Wazneh/rfcx-guardian-pcb/README.md

# rfcx-guardian-pcb
Hardware PCB designs for RFCx Guardians
