Wazneh/rfcx-guardian-pcb/BOM/BOM_RFCX_POWER_BOARD_R1.xlsx

Description | Device | Package | Value | Qty | Price | Ex. Price | Parts | MFG PN | Manufacturer | Digikey PN | Digi cart
3.5mm Terminal block | TERMBLOCK_1X2 | TERMBLOCK_1X2-3.5MM | 2POS HORIZ 3.5MM T/H | 1 | $0.57 | $0.57 | X1 | 691103110002 | Wurth Electronics Inc. | 732-2745-ND (https://www.digikey.com/product-detail/en/wurth-electronics-inc/691103110002/732-2745-ND/2508514)
CAPACITOR, American symbol | C-USC1210 | C1210 | 100uF | 1 | $0.58 | $0.58 | C18 | GRM32ER61A107ME20L | Murata | 490-9969-1-ND (https://www.digikey.com/product-detail/en/murata-electronics-north-america/GRM32ER61A107ME20L/490-9969-1-ND/5026474) | CAP CER 100UF 10V X5R 1210
CAPACITOR, American symbol | C-USC0805K | C0805K | 10uF | 7 | $0.08 | $0.56 | C1, C2, C3, C5, C6, C7, C15 | CC0805KKX5R7BB106 | Yageo | 311-1865-1-ND (https://www.digikey.com/products/en?keywords=311-1865-1-ND) | CAP CER 10UF 16V X5R 0805
Ceramic Capacitors | CAP_CERAMIC0805_10MGAP | 0805_10MGAP | 0.1uF | 1 | $0.02 | $0.02 | C17 | CC0805ZRY5V9BB104 | Yageo | 311-1361-1-ND (https://www.digikey.com/product-detail/en/yageo/CC0805ZRY5V9BB104/311-1361-1-ND/2103145) | CAP CER 0.1UF 50V Y5V 0805
Ceramic Capacitors | CAP_CERAMIC0805-NOOUTLINE | 0805-NO | 2.2uF | 1 | $0.04 | $0.04 | C16 | CL21A225KAFNNNG | Samsung | 1276-6458-1-ND (https://www.digikey.com/product-detail/en/samsung-electro-mechanics-america-inc/CL21A225KAFNNNG/1276-6458-1-ND/5958086) | CAP CER 2.2UF 25V X5R 0805
Diode | DIODESOD-123 | SOD-123 | MBR120VLSFT1G | 3 | $0.24 | $0.73 | D1, D2, D3 | MBR120VLSFT1G | ON Semi | MBR120VLSFT1GOSCT-ND (https://www.digikey.com/product-detail/en/on-semiconductor/MBR120VLSFT1G/MBR120VLSFT1GOSCT-ND/893874) | DIODE SCHOTTKY 20V 1A SOD123FL
Inductors | INDUCTORTDK_VLC5045 | INDUCTOR_5X5MM_TDK_VLC5045 | 6.8uH | 1 | $0.30 | $0.30 | L2 | VLS5045EX-6R8M | TDK Corp. | 445-174855-1-ND (https://www.digikey.com/product-detail/en/tdk-corporation/VLS5045EX-6R8M/445-174855-1-ND/6560412) | FIXED IND 6.8UH 2.9A 59.8 MOHM
JST 2-Pin Connectors of various flavors | JST_2PIN-SMT-RA | JST-PH-2-SMT-RA | 3.7 - 4.2 V | 2 | $0.10 | $0.20 | BATT, BATT1 | S2B-PH-SM4-TB(LF)(SN) | JST Sales America Inc. | 455-1749-1-ND (https://www.digikey.com/product-detail/en/jst-sales-america-inc/S2B-PH-SM4-TB(LF)(SN)/455-1749-1-ND/926846) | CONN HEADER PH SIDE 2POS 2MM SMD
LED | LED0805_NOOUTLINE | CHIPLED_0805_NOOUTLINE | BLUE | 1 | $0.14 | $0.14 | LED4 | 150080BS75000 | Wurth | 732-4982-1-ND (https://www.digikey.com/product-detail/en/wurth-electronics-inc/150080BS75000/732-4982-1-ND/4489910) | LED BLUE CLEAR 0805 SMD
LED | LED0805_NOOUTLINE | CHIPLED_0805_NOOUTLINE | GREEN | 2 | $0.09 | $0.19 | DONE, DONE1 | LG R971-KN-1 | OSRAM | 475-1410-1-ND (https://www.digikey.com/product-detail/en/osram-opto-semiconductors-inc/LG-R971-KN-1/475-1410-1-ND/1802598) | LED GREEN DIFFUSED 0805 SMD
LED | LED0805_NOOUTLINE | CHIPLED_0805_NOOUTLINE | RED | 2 | $0.10 | $0.20 | PWR, PWR1 | LS R976-NR-1 | OSRAM | 475-1278-1-ND (https://www.digikey.com/product-detail/en/osram-opto-semiconductors-inc/LS-R976-NR-1/475-1278-1-ND/1642798) | LED RED DIFFUSED 0805 SMD
LED | LED0805_NOOUTLINE | CHIPLED_0805_NOOUTLINE | YELLOW (edit) | 2 | $0.13 | $0.27 | CHRG/LBO, CHRG/LBO1 | LY R976-PS-36 | OSRAM | 475-2560-1-ND (https://www.digikey.com/product-detail/en/osram-opto-semiconductors-inc/LY-R976-PS-36/475-2560-1-ND/1802687) | LED YELLOW DIFFUSED 0805 SMD
MCP QFN | MCP73871 | QFN20_4MM | MCP73871 | 2 | $1.53 | $3.07 | IC1, IC2 | MCP73871-2CCI/ML | Microchip | MCP73871-2CCI/ML-ND (https://www.digikey.com/product-detail/en/microchip-technology/MCP73871-2CCI-ML/MCP73871-2CCI-ML-ND/1680971) | IC USB/AC BATT CHRGR W/PPM 20QFN
PNP Bias Resistor Transistor | MUN2114T1-PNP_DRIVER-SC59-BEC | SC59-BEC | MMUN2133LT1G | 1 | $0.07 | $0.07 | T2 | MMUN2133LT1G | ON Semi | MMUN2133LT1GOSCT-ND (https://www.digikey.com/product-detail/en/on-semiconductor/MMUN2133LT1G/MMUN2133LT1GOSCT-ND/2705149) | TRANS PREBIAS PNP 246MW SOT23-3
POLARIZED CAPACITOR, American symbol | CPOL-USE5-13 | E5-13 | 4700uF/10V | 2 | $0.62 | $1.24 | C4, C8 | UVR1A472MHD1TO | Nichicon | 493-12761-1-ND (https://www.digikey.com/product-detail/en/nichicon/UVR1A472MHD1TO/493-12761-1-ND/4328397) | CAP ALUM 4700UF 20% 10V RADIAL
RESISTOR, American symbol | R-US_R0805 | R0805 | 100K | 4 | $0.01 | $0.05 | R3, R6, R12, R16 | CR0805-FX-1003ELF | Bourns Inc. | CR0805-FX-1003ELFCT-ND (https://www.digikey.com/product-detail/en/bourns-inc/CR0805-FX-1003ELF/CR0805-FX-1003ELFCT-ND/3740923) | RES SMD 100K OHM 1% 1/8W 0805
RESISTOR, American symbol | R-US_FLIPFLOP | 0805-THM | 10K | 2 | $0.01 | $0.02 | THERM, THERM1 | RC0805FR-0710KL | Yageo | 311-10.0KCRCT-ND (https://www.digikey.com/product-detail/en/yageo/RC0805FR-0710KL/311-10.0KCRCT-ND/730482) | RES SMD 10K OHM 1% 1/8W 0805
RESISTOR, American symbol | R-US_M0805 | M0805 | 150K | 2 | $0.60 | $1.20 | RT1, RT2 | RG2012N-154-W-T1 | Susumu | RG20N150KWCT-ND (https://www.digikey.com/product-detail/en/susumu/RG2012N-154-W-T1/RG20N150KWCT-ND/600928) | RES SMD 150K OHM 0.05% 1/8W 0805
RESISTOR, American symbol | R-US_M0805 | M0805 | 1K | 2 | $0.43 | $0.86 | R5, R17 | RT0805BRB071KL | Yageo | YAG4811CT-ND (https://www.digikey.com/product-detail/en/yageo/RT0805BRB071KL/YAG4811CT-ND/6616967) | RES SMD 1K OHM 0.1% 1/8W 0805
RESISTOR, American symbol | R-US_R0805 | R0805 | 1K | 10 | $0.01 | $0.09 | R7, R8, R9, R10, R13, R14, R11, R15, R39, R40 | CR0805-JW-102ELF | Bourns Inc. | CR0805-JW-102ELFCT-ND (https://www.digikey.com/product-detail/en/bourns-inc/CR0805-JW-102ELF/CR0805-JW-102ELFCT-ND/3592930) | RES SMD 1K OHM 5% 1/8W 0805
RESISTOR, American symbol | R-US_R0805 | R0805 | 270K | 2 | $0.08 | $0.16 | R2, R4 | ERJ-PB6D2703V | Panasonic | P21294CT-ND (https://www.digikey.com/product-detail/en/panasonic-electronic-components/ERJ-PB6D2703V/P21294CT-ND/6215549) | RES SMD 270K OHM 0.5% 1/4W 0805
Resistors | RESISTOR0805_NOOUTLINE | 0805-NO | 1.87M | 1 | $0.02 | $0.02 | R42 | ERJ-6ENF1874V | Panasonic | P1.87BTCT-ND (https://www.digikey.com/product-detail/en/panasonic-electronic-components/ERJ-6ENF1874V/P1.87BTCT-ND/4429149) | RES SMD 1.87M OHM 1% 1/8W 0805
Resistors | RESISTOR_0805MP | _0805MP | 1.87M | 1 | $0.02 | $0.02 | R45 | ERJ-6ENF1874V | Panasonic | P1.87BTCT-ND (https://www.digikey.com/product-detail/en/panasonic-electronic-components/ERJ-6ENF1874V/P1.87BTCT-ND/4429149) | RES SMD 1.87M OHM 1% 1/8W 0805
Resistors | RESISTOR0805_NOOUTLINE | 0805-NO | 200K | 2 | $0.01 | $0.03 | R41, R43 | CR0805-FX-2003ELF | Bourns Inc. | CR0805-FX-2003ELFCT-ND (https://www.digikey.com/product-detail/en/bourns-inc/CR0805-FX-2003ELF/CR0805-FX-2003ELFCT-ND/3925389) | RES SMD 200K OHM 1% 1/8W 0805
Resistors | RESISTOR_0805MP | _0805MP | 340K | 1 | $0.01 | $0.01 | R44 | RC0805FR-07340KL | Yageo | 311-340KCRCT-ND (https://www.digikey.com/product-detail/en/yageo/RC0805FR-07340KL/311-340KCRCT-ND/730822) | RES SMD 340K OHM 1% 1/8W 0805
Resistors | RESISTOR0805_NOOUTLINE | 0805-NO | 43K | 1 | $0.01 | $0.01 | R35 | RC0805FR-0743KL | Yageo | 311-43.0KCRCT-ND (https://www.digikey.com/product-detail/en/yageo/RC0805FR-0743KL/311-43.0KCRCT-ND/730900) | RES SMD 43K OHM 1% 1/8W 0805
Resistors | RESISTOR0805_NOOUTLINE | 0805-NO | 49.9K | 2 | $0.04 | $0.09 | R36, R38 | RT0805DRE0749K9L | Yageo | 311-2869-1-ND (https://www.digikey.com/product-detail/en/yageo/RT0805DRE0749K9L/311-2869-1-ND/6129288) | RES SMD 49.9K OHM 0.5% 1/8W 0805
Resistors | RESISTOR0805_NOOUTLINE | 0805-NO | 75K | 1 | $0.04 | $0.04 | R37 | RT0805DRD0775KL | Yageo | 311-2766-1-ND (https://www.digikey.com/product-detail/en/yageo/RT0805DRD0775KL/311-2766-1-ND/6129185) | RES SMD 75K OHM 0.5% 1/8W 0805
TPS6103x 4A Boost - 1.8-5.5V Input, Adjustable Output to 5.5V | VREG_TPS6103X | PVQFN-16 | TPS61090RSAR | 1 | $1.78 | $1.78 | U3 | TPS61090RSAR | TI | 296-15259-1-ND (https://www.digikey.com/products/en/integrated-circuits-ics/pmic-voltage-regulators-dc-dc-switching-regulators/739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) | IC REG BOOST ADJ 2A SYNC 16VQFN
USB - Type A Connector Vertical | USB_TYPEAPTHFML | USB_HOST-PTH | USBA_FEMALE | 1 | $0.47 | $0.47 | CN5 | ED3074-ND | On Shore Technology Inc. | ED3074-ND (https://www.digikey.com/product-detail/en/on-shore-technology-inc/USB-A1VSW60/ED3074-ND/5215840) | CONN USB TYPE A VERTICAL WHITE
