Wazneh/rfcx-guardian-pcb/BOM/PCB_mfg_quotes.xlsx

Manufacturer | Type | Qty | Price | Price/board | Lead Time | Notes
Magnum Engineering | PCB and Assmebly | 15 | $1800 | $120
Magnum Engineering | PCB and Assmebly | 3 | $330 | $110
SF circuits | PCB | 10 | $500 | $50 |  | They charge $500 for a panel which can have up to 10 boards. Representative recommended budgeting around $3000 for full assembly
PCBway | PCB and Assmebly | 5 | $330 | $66 |  | PCB print time is 1-2 days + 5-6 days assembly time + Shipping
PCBway | PCB and Assmebly | 25 | $600 | $24 | 3- 4 weeks | Price is board, parts, and assembly
