Wazneh/rfcx-guardian-pcb/BOM/quote for W41819ASC4 5sets  BOM_Main_Board_2X-SOLAR_5V-DCDC_digikey 2017-6-8.xlsx

Sheet: Sheet1
Remarks | Description | Device | Package | Value | Qty | Parts | MFG PN | Manufacturer | Digikey PN | Digi cart | Comments
 | CAPACITOR, American symbol | C-USC0805K | C0805K | 10uF | 6 | C1, C2, C3, C5, C6, C7 | CC0805KKX5R7BB106 | Yageo | 311-1865-1-ND (https://www.digikey.com/products/en?keywords=311-1865-1-ND) | CAP CER 10UF 16V X5R 0805
 | RESISTOR, American symbol | R-US_R0805 | R0805 | 1K | 6 | R7, R8, R9, R10, R13, R14 | CR0805-JW-102ELF | Bourns Inc. | CR0805-JW-102ELFCT-ND (https://www.digikey.com/product-detail/en/bourns-inc/CR0805-JW-102ELF/CR0805-JW-102ELFCT-ND/3592930) | RES SMD 1K OHM 5% 1/8W 0805
pls tell the part NO. | JST 2-Pin Connectors of various flavors | JST_2PIN-SMT-RA | JST-PH-2-SMT-RA |  | 4 | BATT, BATT1, LOAD, LOAD1 | - | - | -
pls tell the part NO. | Mounting Hole | .5 MOUNTINGHOLE2.5 | MOUNTINGHOLE_2.5_PLATED | MOUNTINGHOLE2 | 4 | U$4, U$5, U$6, U$7 |  |  |  |  | Mounting hole N/A
 | RESISTOR, American symbol | R-US_R0805 | R0805 | 100K | 4 | R3, R6, R12, R16 | CR0805-FX-1003ELF | Bourns Inc. | CR0805-FX-1003ELFCT-ND (https://www.digikey.com/product-detail/en/bourns-inc/CR0805-FX-1003ELF/CR0805-FX-1003ELFCT-ND/3740923) | RES SMD 100K OHM 1% 1/8W 0805
pls tell the part NO. | For use by pick and place machines to calibrate the vision/machine, 1mm | FIDUCIAL | FIDUCIAL_1MM | FIDUCIAL | 3 | U$2, U$3, U$8 |  |  |  |  | FIDUCIAL N/A
pls tell the part NO. | 3.5mm Terminal block | TERMBLOCK_1X2 | TERMBLOCK_1X2-3.5MM |  | 2 | X1, X2 | - | - | -
 | Ceramic Capacitors | CAP_CERAMIC0805-NOOUTLINE | 0805-NO | 10uF | 2 | C15, C20 | CL21A106KQFNNNG | Samsung | 1276-6457-1-ND (https://www.digikey.com/product-detail/en/samsung-electro-mechanics-america-inc/CL21A106KQFNNNG/1276-6457-1-ND/5958085) | CAP CER 10UF 6.3V X5R 0805
 | Diode | DIODESOD-123 | SOD-123 | MBR120VLSFT1G | 2 | D1, D2 | MBR120VLSFT1G | ON Semi | MBR120VLSFT1GOSCT-ND (https://www.digikey.com/product-detail/en/on-semiconductor/MBR120VLSFT1G/MBR120VLSFT1GOSCT-ND/893874) | DIODE SCHOTTKY 20V 1A SOD123FL
5-7WORK DAYS | LED | LED0805_NOOUTLINE | CHIPLED_0805_NOOUTLINE | GREEN | 2 | DONE, DONE1 | LG R971-KN-1 | OSRAM | 475-1410-1-ND (https://www.digikey.com/product-detail/en/osram-opto-semiconductors-inc/LG-R971-KN-1/475-1410-1-ND/1802598) | LED GREEN DIFFUSED 0805 SMD
5-7WORK DAYS | LED | LED0805_NOOUTLINE | CHIPLED_0805_NOOUTLINE | YELLOW (edit) | 2 | CHRG/LBO, CHRG/LBO1 | LY R976-PS-36 | OSRAM | 475-2560-1-ND (https://www.digikey.com/product-detail/en/osram-opto-semiconductors-inc/LY-R976-PS-36/475-2560-1-ND/1802687) | LED YELLOW DIFFUSED 0805 SMD
5-7WORK DAYS | LED | LED0805_NOOUTLINE | CHIPLED_0805_NOOUTLINE | RED | 2 | PWR, PWR1 | LS R976-NR-1 | OSRAM | 475-1278-1-ND (https://www.digikey.com/product-detail/en/osram-opto-semiconductors-inc/LS-R976-NR-1/475-1278-1-ND/1642798) | LED RED DIFFUSED 0805 SMD
 | MCP QFN | MCP73871 | QFN20_4MM | MCP73871 | 2 | IC1, IC2 | MCP73871-2CCI/ML | Microchip | MCP73871-2CCI/ML-ND (https://www.digikey.com/product-detail/en/microchip-technology/MCP73871-2CCI-ML/MCP73871-2CCI-ML-ND/1680971) | IC USB/AC BATT CHRGR W/PPM 20QFN
pls tell the part NO. | PIN HEADER | PINHD-1X3CB | 1X03-CLEANBIG |  | 2 | JP5, JP8 | - | - | -
pls tell the part NO. | PIN HEADER | HEADER-1X2ROUND | 1X02_ROUND | BATT | 2 | JP4, JP7 | - | - | -
pls tell the part NO. | PIN HEADER | HEADER-1X2 | 1X02_OVAL | DCIN | 2 | JP1, JP2 | - | - | -
pls tell the part NO. | PIN HEADER | HEADER-1X2ROUND | 1X02_ROUND | LOAD | 2 | JP3, JP6 | - | - | -
7-10WORK DAYS | POLARIZED CAPACITOR, American symbol | CPOL-USE5-13 | E5-13 | 4700uF/10V | 2 | C4, C8 | UVR1A472MHD1TO | Nichicon | 493-12761-1-ND (https://www.digikey.com/product-detail/en/nichicon/UVR1A472MHD1TO/493-12761-1-ND/4328397) | CAP ALUM 4700UF 20% 10V RADIAL
 | RESISTOR, American symbol | R-US_FLIPFLOP | 0805-THM | 10K | 2 | THERM, THERM1 | RC0805FR-0710KL | Yageo | 311-10.0KCRCT-ND (https://www.digikey.com/product-detail/en/yageo/RC0805FR-0710KL/311-10.0KCRCT-ND/730482) | RES SMD 10K OHM 1% 1/8W 0805
5-7WORK DAYS | RESISTOR, American symbol | R-US_M0805 | M0805 | 150K | 2 | RT1, RT2 | RG2012N-154-W-T1 | Susumu | RG20N150KWCT-ND (https://www.digikey.com/product-detail/en/susumu/RG2012N-154-W-T1/RG20N150KWCT-ND/600928) | RES SMD 150K OHM 0.05% 1/8W 0805
5-7WORK DAYS | RESISTOR, American symbol | R-US_M0805 | M0805 | 1K | 2 | R5, R17 | RT0805BRB071KL | Yageo | YAG4811CT-ND (https://www.digikey.com/product-detail/en/yageo/RT0805BRB071KL/YAG4811CT-ND/6616967) | RES SMD 1K OHM 0.1% 1/8W 0805
 | RESISTOR, American symbol | R-US_FLIPFLOP | 0805-THM | 1K | 2 | R11, R15 | CR0805-JW-102ELF | Bourns Inc. | CR0805-JW-102ELFCT-ND (https://www.digikey.com/product-detail/en/bourns-inc/CR0805-JW-102ELF/CR0805-JW-102ELFCT-ND/3592930) | RES SMD 1K OHM 5% 1/8W 0805
 | Resistors | RESISTOR0805_NOOUTLINE | 0805-NO | 1K | 2 | R39, R40 | CR0805-JW-102ELF | Bourns Inc. | CR0805-JW-102ELFCT-ND (https://www.digikey.com/product-detail/en/bourns-inc/CR0805-JW-102ELF/CR0805-JW-102ELFCT-ND/3592930) | RES SMD 1K OHM 5% 1/8W 0805
 | Resistors | RESISTOR0805_NOOUTLINE | 0805-NO | 200K | 2 | R41, R43 | CR0805-FX-2003ELF | Bourns Inc. | CR0805-FX-2003ELFCT-ND (https://www.digikey.com/products/en/resistors/chip-resistor-surface-mount/52?k=R0805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) | RES SMD 200K OHM 1% 1/8W 0805
7-10WORK DAYS | RESISTOR, American symbol | R-US_R0805 | R0805 | 270K | 2 | R2, R4 | ERJ-PB6D2703V | Panasonic | P21294CT-ND (https://www.digikey.com/product-detail/en/panasonic-electronic-components/ERJ-PB6D2703V/P21294CT-ND/6215549) | RES SMD 270K OHM 0.5% 1/4W 0805
5-7WORK DAYS | CAPACITOR, American symbol | C-USC1210 | C1210 | 100uF | 1 | C18 | GRM32ER61A107ME20L | Murata | 490-9969-1-ND (https://www.digikey.com/product-detail/en/murata-electronics-north-america/GRM32ER61A107ME20L/490-9969-1-ND/5026474) | CAP CER 100UF 10V X5R 1210
 | Ceramic Capacitors | CAP_CERAMIC0805_10MGAP | 0805_10MGAP | 0.1uF | 1 | C17 | CC0805ZRY5V9BB104 | Yageo | 311-1361-1-ND (https://www.digikey.com/product-detail/en/yageo/CC0805ZRY5V9BB104/311-1361-1-ND/2103145) | CAP CER 0.1UF 50V Y5V 0805
 | Ceramic Capacitors | CAP_CERAMIC0805-NOOUTLINE | 0805-NO | 2.2uF | 1 | C16 | CL21A225KAFNNNG | Samsung | 1276-6458-1-ND (https://www.digikey.com/product-detail/en/samsung-electro-mechanics-america-inc/CL21A225KAFNNNG/1276-6458-1-ND/5958086) | CAP CER 2.2UF 25V X5R 0805
pls tell the part NO. | DC Barrel Jack | DCBARRELSMT | DCJACK_2MM_SMT | DCIN | 1 | CN1 | - | - | -
5-7WORK DAYS | Inductors | INDUCTORTDK_VLC5045 | INDUCTOR_5X5MM_TDK_VLC5045 | 6.8uH | 1 | L2 | VLS5045EX-6R8M | TDK Corp. | 445-174855-1-ND (https://www.digikey.com/product-detail/en/tdk-corporation/VLS5045EX-6R8M/445-174855-1-ND/6560412) | FIXED IND 6.8UH 2.9A 59.8 MOHM | Original part obsoleted, replacement part picked
7-10WORK DAYS | LED | LED0805_NOOUTLINE | CHIPLED_0805_NOOUTLINE | BLUE | 1 | LED4 | 150080BS75000 | Wurth | 732-4982-1-ND (https://www.digikey.com/product-detail/en/wurth-electronics-inc/150080BS75000/732-4982-1-ND/4489910) | LED BLUE CLEAR 0805 SMD
pls tell the part NO. | PIN HEADER | HEADER-1X8ROUND | 1X08_ROUND |  | 1 | JP10
 | PNP Bias Resistor Transistor | MUN2114T1-PNP_DRIVER-SC59-BEC | SC59-BEC | MMUN2133LT1G | 1 | T2 | MMUN2133LT1G | ON Semi | MMUN2133LT1GOSCT-ND (https://www.digikey.com/product-detail/en/on-semiconductor/MMUN2133LT1G/MMUN2133LT1GOSCT-ND/2705149) | TRANS PREBIAS PNP 246MW SOT23-3 | Part # and device do not match but 2133 PNP should work fine
 | RESISTOR, American symbol | R-US_R0805 | R0805 | 0 | 1 | R1 | RC0805JR-070RL | Yageo | 311-0.0ARCT-ND (https://www.digikey.com/product-detail/en/yageo/RC0805JR-070RL/311-0.0ARCT-ND/731163) | RES SMD 0.0 OHM JUMPER 1/8W 0805
5-7WORK DAYS | Resistors | RESISTOR0805_NOOUTLINE | 0805-NO | 1.87M | 1 | R42 | ERJ-6ENF1874V | Panasonic | P1.87BTCT-ND (https://www.digikey.com/product-detail/en/panasonic-electronic-components/ERJ-6ENF1874V/P1.87BTCT-ND/4429149) | RES SMD 1.87M OHM 1% 1/8W 0805
5-7WORK DAYS | Resistors | RESISTOR_0805MP | _0805MP | 1.87M | 1 | R45 | ERJ-6ENF1874V | Panasonic | P1.87BTCT-ND (https://www.digikey.com/product-detail/en/panasonic-electronic-components/ERJ-6ENF1874V/P1.87BTCT-ND/4429149) | RES SMD 1.87M OHM 1% 1/8W 0805
 | Resistors | RESISTOR_0805MP | _0805MP | 340K | 1 | R44 | RC0805FR-07340KL | Yageo | 311-340KCRCT-ND (https://www.digikey.com/product-detail/en/yageo/RC0805FR-07340KL/311-340KCRCT-ND/730822) | RES SMD 340K OHM 1% 1/8W 0805
 | Resistors | RESISTOR0805_NOOUTLINE | 0805-NO | 43K | 1 | R35 | RC0805FR-0743KL | Yageo | 311-43.0KCRCT-ND (https://www.digikey.com/product-detail/en/yageo/RC0805FR-0743KL/311-43.0KCRCT-ND/730900) | RES SMD 43K OHM 1% 1/8W 0805
5-7WORK DAYS | Resistors | RESISTOR0805_NOOUTLINE | 0805-NO | 49.9K | 1 | R36 | RT0805DRE0749K9L | Yageo | 311-2869-1-ND (https://www.digikey.com/product-detail/en/yageo/RT0805DRE0749K9L/311-2869-1-ND/6129288) | RES SMD 49.9K OHM 0.5% 1/8W 0805
5-7WORK DAYS | Resistors | RESISTOR0805_NOOUTLINE | 0805-NO | 49.9K 1% | 1 | R38 | RT0805DRE0749K9L | Yageo | 311-2869-1-ND (https://www.digikey.com/product-detail/en/yageo/RT0805DRE0749K9L/311-2869-1-ND/6129288) | RES SMD 49.9K OHM 0.5% 1/8W 0805
5-7WORK DAYS | Resistors | RESISTOR0805_NOOUTLINE | 0805-NO | 75K 1% | 1 | R37 | RT0805DRD0775KL | Yageo | 311-2766-1-ND (https://www.digikey.com/product-detail/en/yageo/RT0805DRD0775KL/311-2766-1-ND/6129185) | RES SMD 75K OHM 0.5% 1/8W 0805
 | TPS6103x 4A Boost - 1.8-5.5V Input, Adjustable Output to 5.5V | VREG_TPS6103X | PVQFN-16 | TPS61090RSAR | 1 | U3 | TPS61090RSAR | TI | 296-15259-1-ND (https://www.digikey.com/products/en/integrated-circuits-ics/pmic-voltage-regulators-dc-dc-switching-regulators/739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) | IC REG BOOST ADJ 2A SYNC 16VQFN
pls tell the part NO. | USB - Type A Connectors | USB_TYPEAPTHFML | USB_HOST-PTH | USBA_FEMALE | 1 | CN5 | - | - | -
pls tell the part NO. | USB Connectors | USBMINIBLARGE | USB-MINIB_LARGER |  | 1 | CN4 | - | - | -
pls tell the part NO. | USB Connectors | USBMICRO_20329 | 4UCONN_20329 | MicroUSB | 1 | CN6 | - | - | -

Sheet: 2017-06-07T13-52-05
5SETS |  | 型号 | Index | Quantity | Part Number | Description | Customer Reference | Available Quantity | Backorder Quantity | Unit Price USD | Extended Price USD
$0.050 |  | CC0805KKX5R7BB106 | 1 | 24 | 311-1865-1-ND | CAP CER 10UF 16V X5R 0805 |  | 24 | 0 | 0.159 | 3.82
$0.200 |  | MBR120VLSFT1G | 2 | 10 | MBR120VLSFT1GOSCT-ND | DIODE SCHOTTKY 20V 1A SOD123FL |  | 10 | 0 | 0.391 | 3.91
$1.850 | 5-7work days | GRM32ER61A107ME20L | 3 | 10 | 490-9969-1-ND | CAP CER 100UF 10V X5R 1210 |  | 10 | 0 | 0.822 | 8.22
$0.050 |  | CL21A106KQFNNNG | 4 | 20 | 1276-6457-1-ND | CAP CER 10UF 6.3V X5R 0805 |  | 12 | 8 | 0.075 | 1.5
$0.050 |  | CC0805ZRY5V9BB104 | 5 | 10 | 311-1361-1-ND | CAP CER 0.1UF 50V Y5V 0805 |  | 10 | 0 | 0.038 | 0.38
$0.050 |  | CL21A225KAFNNNG | 6 | 10 | 1276-6458-1-ND | CAP CER 2.2UF 25V X5R 0805 |  | 10 | 0 | 0.084 | 0.84
$0.300 | 5-7work days | LG R971-KN-1 | 7 | 10 | 475-1410-1-ND | LED GREEN DIFFUSED 0805 SMD |  | 10 | 0 | 0.18 | 1.8
$0.300 | 5-7work days | LY R976-PS-36 | 8 | 10 | 475-2560-1-ND | LED YELLOW DIFFUSED 0805 SMD |  | 10 | 0 | 0.253 | 2.53
$0.300 | 5-7work days | LS R976-NR-1 | 9 | 10 | 475-1278-1-ND | LED RED DIFFUSED 0805 SMD |  | 10 | 0 | 0.19 | 1.9
$0.300 | 7-10work days | 150080BS75000 | 10 | 10 | 732-4982-1-ND | LED BLUE CLEAR 0805 SMD |  | 10 | 0 | 0.17 | 1.7
$1.200 | 7-10work days | UVR1A472MHD1TO | 11 | 6 | 493-12761-1-ND | CAP ALUM 4700UF 20% 10V RADIAL |  | 6 | 0 | 1.05 | 6.3
$1.600 |  | MCP73871-2CCI/ML | 12 | 6 | MCP73871-2CCI/ML-ND | IC USB/AC BATT CHRGR W/PPM 20QFN |  | 6 | 0 | 1.84 | 11.04
$0.050 |  | RC0805FR-0710KL | 13 | 10 | 311-10.0KCRCT-ND | RES SMD 10K OHM 1% 1/8W 0805 |  | 10 | 0 | 0.021 | 0.21
$1.200 | 5-7work days | RG2012N-154-W-T1 | 14 | 10 | RG20N150KWCT-ND | RES SMD 150K OHM 0.05% 1/8W 0805 |  | 10 | 0 | 0.827 | 8.27
$1.200 | 5-7work days | RT0805BRB071KL | 15 | 10 | YAG4811CT-ND | RES SMD 1K OHM 0.1% 1/8W 0805 |  | 10 | 0 | 0.641 | 6.41
$0.050 |  | CR0805-JW-102ELF | 16 | 10 | CR0805-JW-102ELFCT-ND | RES SMD 1K OHM 5% 1/8W 0805 |  | 10 | 0 | 0.065 | 0.65
$0.050 |  | CR0805-FX-2003ELF | 17 | 10 | CR0805-FX-2003ELFCT-ND | RES SMD 200K OHM 1% 1/8W 0805 |  | 10 | 0 | 0.03 | 0.3
$0.400 | 7-10work days | ERJ-PB6D2703V | 18 | 10 | P21294CT-ND | RES SMD 270K OHM 0.5% 1/4W 0805 |  | 10 | 0 | 0.204 | 2.04
$0.050 |  | RC0805JR-070RL | 19 | 10 | 311-0.0ARCT-ND | RES SMD 0.0 OHM JUMPER 1/8W 0805 |  | 10 | 0 | 0.018 | 0.18
$0.200 | 5-7work days | ERJ-6ENF1874V | 20 | 10 | P1.87BTCT-ND | RES SMD 1.87M OHM 1% 1/8W 0805 |  | 10 | 0 | 0.038 | 0.38
$0.050 |  | RC0805FR-07340KL | 21 | 10 | 311-340KCRCT-ND | RES SMD 340K OHM 1% 1/8W 0805 |  | 10 | 0 | 0.021 | 0.21
$0.050 |  | RC0805FR-0743KL | 22 | 10 | 311-43.0KCRCT-ND | RES SMD 43K OHM 1% 1/8W 0805 |  | 10 | 0 | 0.021 | 0.21
$0.200 | 5-7work days | RT0805DRE0749K9L | 23 | 10 | 311-2869-1-ND | RES SMD 49.9K OHM 0.5% 1/8W 0805 |  | 10 | 0 | 0.116 | 1.16
$0.200 | 5-7work days | RT0805DRD0775KL | 24 | 10 | 311-2766-1-ND | RES SMD 75K OHM 0.5% 1/8W 0805 |  | 10 | 0 | 0.116 | 1.16
$2.600 |  | TPS61090RSAR | 25 | 3 | 296-15259-1-ND | IC REG BOOST ADJ 2A SYNC 16VQFN |  | 3 | 0 | 2.46 | 7.38
$0.050 |  | CR0805-FX-1003ELF | 26 | 10 | CR0805-FX-1003ELFCT-ND | RES SMD 100K OHM 1% 1/8W 0805 |  | 10 | 0 | 0.03 | 0.3
$0.800 | 5-7work days | VLS5045EX-6R8M | 27 | 5 | 445-174855-1-ND | FIXED IND 6.8UH 2.9A 59.8 MOHM |  | 5 | 0 | 0.47 | 2.35
$0.100 |  | MMUN2133LT1G | 28 | 10 | MMUN2133LT1GOSCT-ND | TRANS PREBIAS PNP 246MW SOT23-3 |  | 10 | 0 | 0.124 | 1.24
0.5KG
此报价不包含10%的返点

Sheet: 2017-06-06T19-29-56
5SETS |  | 型号 | Index | Quantity | Part Number | Description | Customer Reference | Available Quantity | Backorder Quantity | Unit Price USD | Extended Price USD
$0.050 |  | CC0805KKX5R7BB106 | 1 | 24 | 311-1865-1-ND | CAP CER 10UF 16V X5R 0805 |  | 24 | 0 | 0.159 | 3.82
$0.200 |  | MBR120VLSFT1G | 2 | 10 | MBR120VLSFT1GOSCT-ND | DIODE SCHOTTKY 20V 1A SOD123FL |  | 10 | 0 | 0.391 | 3.91
$1.850 | 5-7work days | GRM32ER61A107ME20L | 3 | 10 | 490-9969-1-ND | CAP CER 100UF 10V X5R 1210 |  | 10 | 0 | 0.822 | 8.22
$0.050 |  | CL21A106KQFNNNG | 4 | 20 | 1276-6457-1-ND | CAP CER 10UF 6.3V X5R 0805 |  | 12 | 8 | 0.075 | 1.5
$0.050 |  | CC0805ZRY5V9BB104 | 5 | 10 | 311-1361-1-ND | CAP CER 0.1UF 50V Y5V 0805 |  | 10 | 0 | 0.038 | 0.38
$0.050 |  | CL21A225KAFNNNG | 6 | 10 | 1276-6458-1-ND | CAP CER 2.2UF 25V X5R 0805 |  | 10 | 0 | 0.084 | 0.84
$0.300 | 5-7work days | LG R971-KN-1 | 7 | 10 | 475-1410-1-ND | LED GREEN DIFFUSED 0805 SMD |  | 10 | 0 | 0.18 | 1.8
$0.300 | 5-7work days | LY R976-PS-36 | 8 | 10 | 475-2560-1-ND | LED YELLOW DIFFUSED 0805 SMD |  | 10 | 0 | 0.253 | 2.53
$0.300 | 5-7work days | LS R976-NR-1 | 9 | 10 | 475-1278-1-ND | LED RED DIFFUSED 0805 SMD |  | 10 | 0 | 0.19 | 1.9
$0.300 | 7-10work days | 150080BS75000 | 10 | 10 | 732-4982-1-ND | LED BLUE CLEAR 0805 SMD |  | 10 | 0 | 0.17 | 1.7
$1.200 | 7-10work days | UVR1A472MHD1TO | 11 | 6 | 493-12761-1-ND | CAP ALUM 4700UF 20% 10V RADIAL |  | 6 | 0 | 1.05 | 6.3
$1.600 |  | MCP73871-2CCI/ML | 12 | 6 | MCP73871-2CCI/ML-ND | IC USB/AC BATT CHRGR W/PPM 20QFN |  | 6 | 0 | 1.84 | 11.04
$0.050 |  | RC0805FR-0710KL | 13 | 10 | 311-10.0KCRCT-ND | RES SMD 10K OHM 1% 1/8W 0805 |  | 10 | 0 | 0.021 | 0.21
$1.200 | 5-7work days | RG2012N-154-W-T1 | 14 | 10 | RG20N150KWCT-ND | RES SMD 150K OHM 0.05% 1/8W 0805 |  | 10 | 0 | 0.827 | 8.27
$1.200 | 5-7work days | RT0805BRB071KL | 15 | 10 | YAG4811CT-ND | RES SMD 1K OHM 0.1% 1/8W 0805 |  | 10 | 0 | 0.641 | 6.41
$0.050 |  | CR0805-JW-102ELF | 16 | 10 | CR0805-JW-102ELFCT-ND | RES SMD 1K OHM 5% 1/8W 0805 |  | 10 | 0 | 0.065 | 0.65
$0.050 |  | CR0805-FX-2003ELF | 17 | 10 | CR0805-FX-2003ELFCT-ND | RES SMD 200K OHM 1% 1/8W 0805 |  | 10 | 0 | 0.03 | 0.3
$0.400 | 7-10work days | ERJ-PB6D2703V | 18 | 10 | P21294CT-ND | RES SMD 270K OHM 0.5% 1/4W 0805 |  | 10 | 0 | 0.204 | 2.04
$0.050 |  | RC0805JR-070RL | 19 | 10 | 311-0.0ARCT-ND | RES SMD 0.0 OHM JUMPER 1/8W 0805 |  | 10 | 0 | 0.018 | 0.18
$0.200 | 5-7work days | ERJ-6ENF1874V | 20 | 10 | P1.87BTCT-ND | RES SMD 1.87M OHM 1% 1/8W 0805 |  | 10 | 0 | 0.038 | 0.38
$0.050 |  | RC0805FR-07340KL | 21 | 10 | 311-340KCRCT-ND | RES SMD 340K OHM 1% 1/8W 0805 |  | 10 | 0 | 0.021 | 0.21
$0.050 |  | RC0805FR-0743KL | 22 | 10 | 311-43.0KCRCT-ND | RES SMD 43K OHM 1% 1/8W 0805 |  | 10 | 0 | 0.021 | 0.21
$0.200 | 5-7work days | RT0805DRE0749K9L | 23 | 10 | 311-2869-1-ND | RES SMD 49.9K OHM 0.5% 1/8W 0805 |  | 10 | 0 | 0.116 | 1.16
$0.200 | 5-7work days | RT0805DRD0775KL | 24 | 10 | 311-2766-1-ND | RES SMD 75K OHM 0.5% 1/8W 0805 |  | 10 | 0 | 0.116 | 1.16
$2.600 |  | TPS61090RSAR | 25 | 3 | 296-15259-1-ND | IC REG BOOST ADJ 2A SYNC 16VQFN |  | 3 | 0 | 2.46 | 7.38
$0.050 |  | CR0805-FX-1003ELF | 26 | 10 | CR0805-FX-1003ELFCT-ND | RES SMD 100K OHM 1% 1/8W 0805 |  | 10 | 0 | 0.03 | 0.3
0.5KG
此报价不包含10%的返点
