Wazneh/rfcx-guardian-pcb/BOM/Template-file/a-sample-of-PCBWay-BOM.xlsx

Sheet: 1
No. | part number/description | Package | Value | Qty | RefDefs | Note
1 |  | C-EUC0402_TI | 220nF | 76 | C1-C14，C16-C46，C48-C53，C56-C58，C65-C73，C77，C78，C95，C100，C103，C104，C105，C106，C107，C121，C123，C128，C137
2 |  | C-EUC0402_TI | 1nF | 8 | C113，C114，C115，C116，C143，C147，C147，C161
3 |  | C-EUC0402_TI | 100nF | 8 | C80，C82，C93，C109，C110，C111，C120，C126
4 |  | C-EUC0603_DWS | 22pF | 2 | C175，C183
5 |  | C-EUC0603_DWS | 1uF | 6 | C79，C99，C133，C145，C150，C154
6 |  | C-EUC0603_DWS | 10pF | 2 | C81，C85
7 |  | C-EUC0603_DWS | 10uF/6.3V | 21 | C101，C102，C108，C117，C124，C130，C132，C134，C135，C136，C138，C142，C144，C146，C149，C153，C157，C158，C159，C160，C163
8 |  | C-EUC0603_DWS | 1uF/6.3V | 1 | C127
9 |  | C-EUC0603_DWS | 22uF/6.3V | 23 | C15，C83，C92，C94，C96，C97，C98，C112，C118，C119，C122，C125，C139，C176-C182，C184，C185，C186
10 |  | C-EUC0603_DWS | 33pF | 2 | C90，C91
11 |  | C-EUC0603_DWS | 4.7uF/6.3V | 1 | C129
12 | Resistor | R-EU_R0402_TI | 0R | 2 | R12-R13
13 |  | R-EU_R0402_TI | 2.2k | 5 | R60，R61，R62，R63，R64
14 |  | R-EU_R0402_TI | 22R | 2 | R9，R11
15 |  | R-EU_R0603_5MIL_DWS | 4.99k/1% | 3 | R33，R68，R71
16 |  | R-EU_R0603_5MIL_DWS | 330R/1% | 1 | R14
17 |  | R-EU_R0603_5MIL_DWS | 3.32k/1% | 1 | R70
18 |  | R-EU_R0603_5MIL_DWS | 2k/1% | 7 | R2，R3，R5，R6，R7，R30，R31
19 |  | R-EU_R0603_5MIL_DWS | 237R/1% | 1 | R8
20 |  | R-EU_R0603_5MIL_DWS | 2.2k | 4 | R1，R45，R46，R56
21 |  | R-EU_R0603_5MIL_DWS | 0R | 3 | R34，R38，R39
22 |  | R-EU_R0603_5MIL_DWS | 1.1k/1% | 2 | R69，R72
23 |  | R-EU_R0603_5MIL_DWS | 100k/1% | 3 | R10，R26，R53
24 |  | R-EU_R0603_5MIL_DWS | 100R | 1 | R50
 | PCBWay PCB Assembly Service

Sheet: Sheet1
U2 MT9V022I77ATM_ES@IBGA-52
U1 EMP7032SLC44-15@TQFP12FL12-44
J2 HEADER_13X2@CON26
J1 DOWNCABLE@CON10
X1 OSC@KDS-OSC-2025
C2 CAP_NP@CAP0402
C3 CAP_NP@CAP0402
C8 CAP_NP@CAP0402
C5 CAP_NP@CAP0402
C6 CAP_NP@CAP0402
C7 CAP_NP@CAP0402
C10 CAP_NP@CAP0402
C9 CAP_NP@CAP0402
C11 CAPACITOR_POL@SMC3528
C12 CAPACITOR_POL@SMC3528
L3 INDUCTOR@SMC0603
L2 INDUCTOR@SMC0603
C1 CAP_NP@CAP0402
L1 INDUCTOR@SMC0603
C4 CAP_NP@CAP0402
U3 COMPONENT_1@SOT23-5
C15 1-CAP-POL-MY@SMC3528
C16 1-CAP-POL-MY@SMC3528
R1 R@RES0402
R2 R@RES0402
C13 CAPACITOR_POL@SMC3528
U4 COMPONENT_1@SOT23-5
C19 1-CAP-POL-MY@SMC3528
C20 1-CAP-POL-MY@SMC3528
C14 CAP_NP@CAP0402
C17 CAP_NP@CAP0402
C22 CAP_NP@CAP0402
C18 CAP_NP@CAP0402
C21 CAP_NP@CAP0402
C23 CAP_NP@CAP0402
R3 R@RES0402
R4 R@RES0402
