Wazneh/rfcx-guardian-pcb/pcb/GERBER/Coordinates_parts_file.txt

BATT 12.70  5.93 180 3.7V Li-ion JST-PH-2-SMT-RA
BATT1 39.37  5.93 180 3.7V Li-ion JST-PH-2-SMT-RA
C1 28.09  2.39 270 10uF C0805K
C2 12.83 12.45   0 10uF C0805K
C3 14.99 17.68 270 10uF C0805K
C5 57.96 14.78  90 10uF C0805K
C6 39.50 12.45   0 10uF C0805K
C7 41.66 17.68 270 10uF C0805K
C15 64.01 21.59 180 10uF 0805-NO
C16 72.90 22.23 270 2.2uF 0805-NO
C17 63.50  9.53   0 0.1uF 0805_10MGAP
C18 70.61 10.16 270 100uF C1210
CHRG/LBO 19.18  8.26 180 ORANGE CHIPLED_0805_NOOUTLINE
CHRG/LBO1 45.85  8.26 180 ORANGE CHIPLED_0805_NOOUTLINE
D1 21.84 25.53  90 MBR120VLSFT1G SOD-123
D2 49.53  5.08 180 MBR120VLSFT1G SOD-123
D3 57.73  6.93  90 MBR120VLSFT1G SOD-123
DONE 26.54  8.26 180 GREEN CHIPLED_0805_NOOUTLINE
DONE1 53.21  8.26 180 GREEN CHIPLED_0805_NOOUTLINE
IC1 20.70 19.30   0 MCP73871 QFN20_4MM
IC2 47.37 19.30   0 MCP73871 QFN20_4MM
L2 68.85 20.98   0 6.8uH INDUCTOR_5X5MM_TDK_VLC5045
LED4 75.12  8.16 270 BLUE CHIPLED_0805_NOOUTLINE
PWR  8.78 27.37 270 RED CHIPLED_0805_NOOUTLINE
PWR1 37.99 27.36 270 RED CHIPLED_0805_NOOUTLINE
R2 20.26 12.65   0 270K R0805
R3 24.97 12.65 180 100K R0805
R4 46.93 12.65   0 270K R0805
R5 12.45 15.75  90 1K M0805
R6 51.64 12.65 180 100K R0805
R7 48.13  8.26 270 1K R0805
R8 21.46  8.26 270 1K R0805
R9 24.00  8.26 270 1K R0805
R10 12.59 24.45   0 1K R0805
R12 27.18 16.97  90 100K R0805
R13 50.67  8.26 270 1K R0805
R14 34.94 26.40 270 1K R0805
R16 53.85 16.97  90 100K R0805
R17 39.12 15.75  90 1K M0805
R35 72.95 14.99 270 43K 0805-NO
R36 72.93 18.60  90 49.9K 0805-NO
R37 74.42 25.65 180 75K 1% 0805-NO
R38 77.85 26.29   0 49.9K 1% 0805-NO
R39 60.29 22.97 270 1K 0805-NO
R40 73.15 11.18 270 1K 0805-NO
R41 63.59 13.97  90 200K 0805-NO
R42 67.95 10.67 270 1.87M 0805-NO
R43 66.17 11.18  90 200K 0805-NO
R44 64.01 17.78   0 340K _0805MP
R45 64.01 19.69 180 1.87M _0805MP
RT1 39.12 20.17 270 150K M0805
RT2 12.45 20.57 270 150K M0805
T2 59.21 19.30   0 MMUN2133LT1G SC59-BEC
U$3 72.39 31.50   0 FIDUCIAL FIDUCIAL_1MM
U$8  6.35  7.62   0 FIDUCIAL FIDUCIAL_1MM
U3 68.72 15.29 180 TPS61090RSAR PVQFN-16
