Wazneh/rfcx-guardian-pcb/BOM/Template-file/Components-positions-sample .pdf

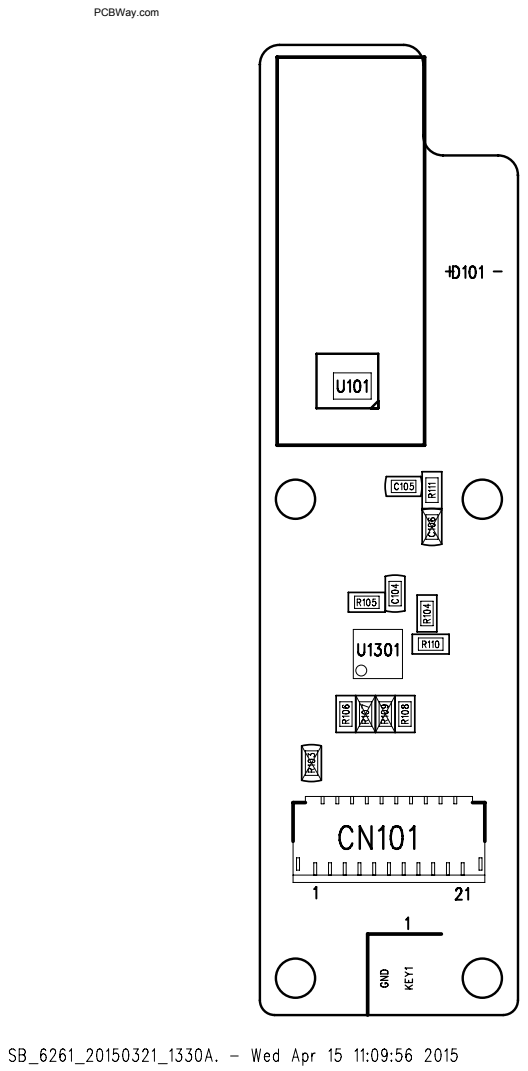
[picture p1: page 1]
PCBWay.com

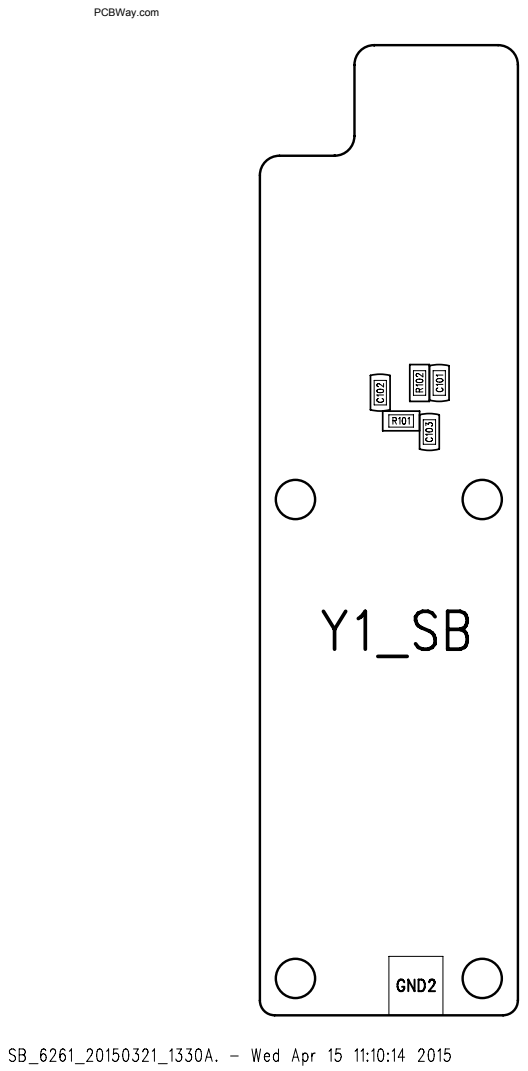
[picture p2: page 2]
PCBWay.com
