Wazneh/rfcx-guardian-pcb/TI_charge_BMS_BUCK_BQ25898.pdf

## WEBENCH ® Design Report

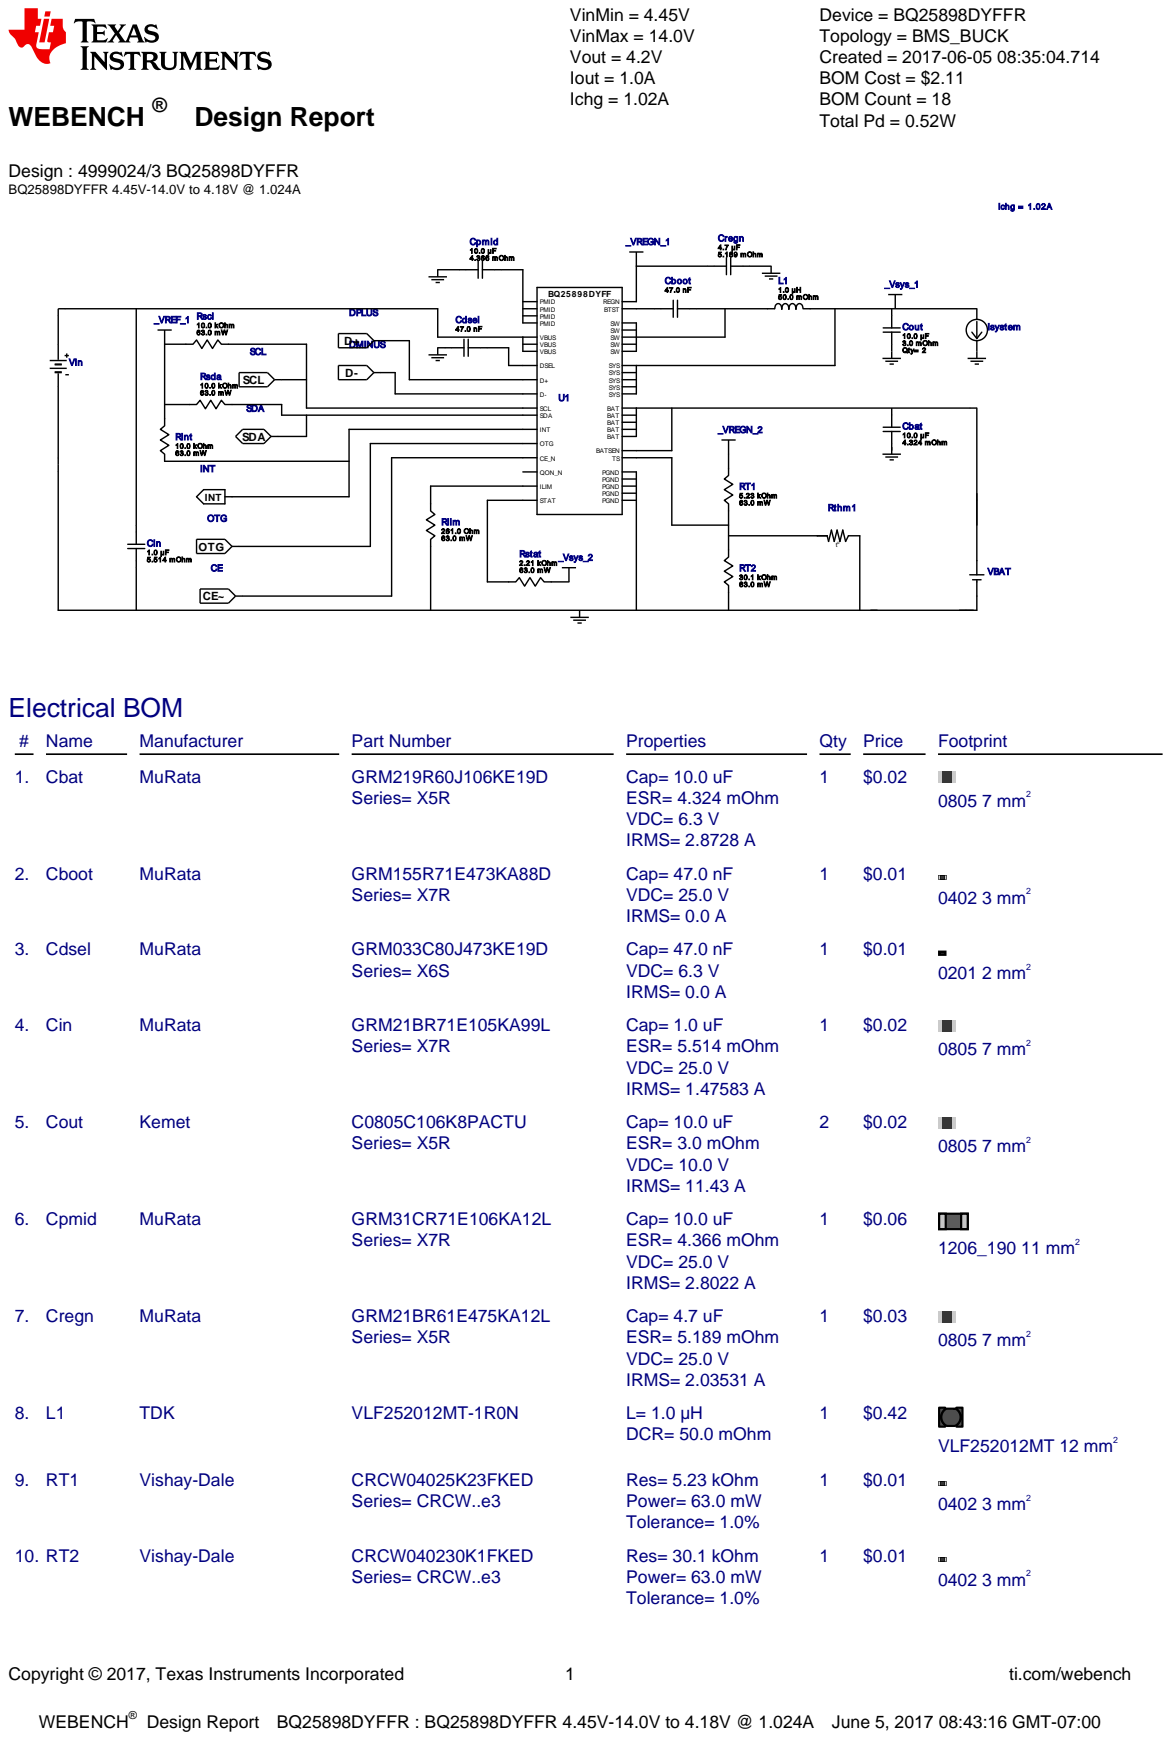
[picture p3: page 1]
Copyright © 2017, Texas Instruments Incorporated; ti.com/webench; WEBENCH®; Design : 4999024/3 BQ25898DYFFR BQ25898DYFFR 4.45V-14.0V to 4.18V @ 1.024A; VinMin = 4.45V VinMax = 14.0V Vout = 4.2V Iout = 1.0A Ichg = 1.02A; Device = BQ25898DYFFR Topology = BMS_BUCK Created = 2017-06-05 08:35:04.714 BOM Cost = $2.11 BOM Count = 18 Total Pd = 0.52W; Cbat 10.0 µF; 4.324 mOhm; Cboot 47.0 nF; Cdsel 47.0 nF; Cin 1.0 µF 5.514 mOhm; Cout 10.0 µF; 3.0 mOhm Qty= 2; Cpmid 10.0 µF 4.366 mOhm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

Design Report BQ25898DYFFR : BQ25898DYFFR 4.45V-14.0V to 4.18V @ 1.024A June 5, 2017 08:43:16 GMT-07:00

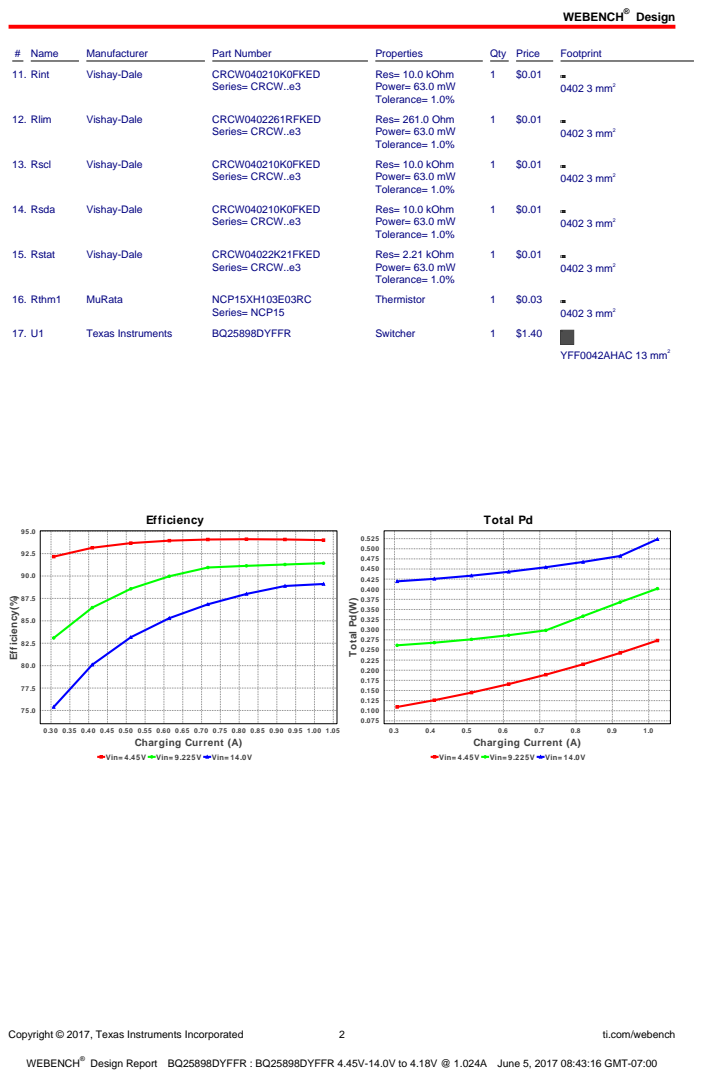
[picture p4: page 2]
Design; Copyright © 2017, Texas Instruments Incorporated; ti.com/webench; # Name; Manufacturer; Part Number; Properties; Qty Price; Footprint; 11. Rint; Vishay-Dale; CRCW040210K0FKED; Series= CRCW..e3; Res= 10.0 kOhm Power= 63.0 mW Tolerance= 1.0%; 0402 3 mm²; 12. Rlim; CRCW0402261RFKED; Res= 261.0 Ohm Power= 63.0 mW Tolerance= 1.0%; 13. Rscl; 14. Rsda; 15. Rstat; CRCW04022K21FKED; Res= 2.21 kOhm Power= 63.0 mW Tolerance= 1.0%; 16. Rthm1; MuRata; NCP15XH103E03RC; Series= NCP15; Thermistor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

Vin= 4.45V Vin= 9.225V Vin= 14.0V

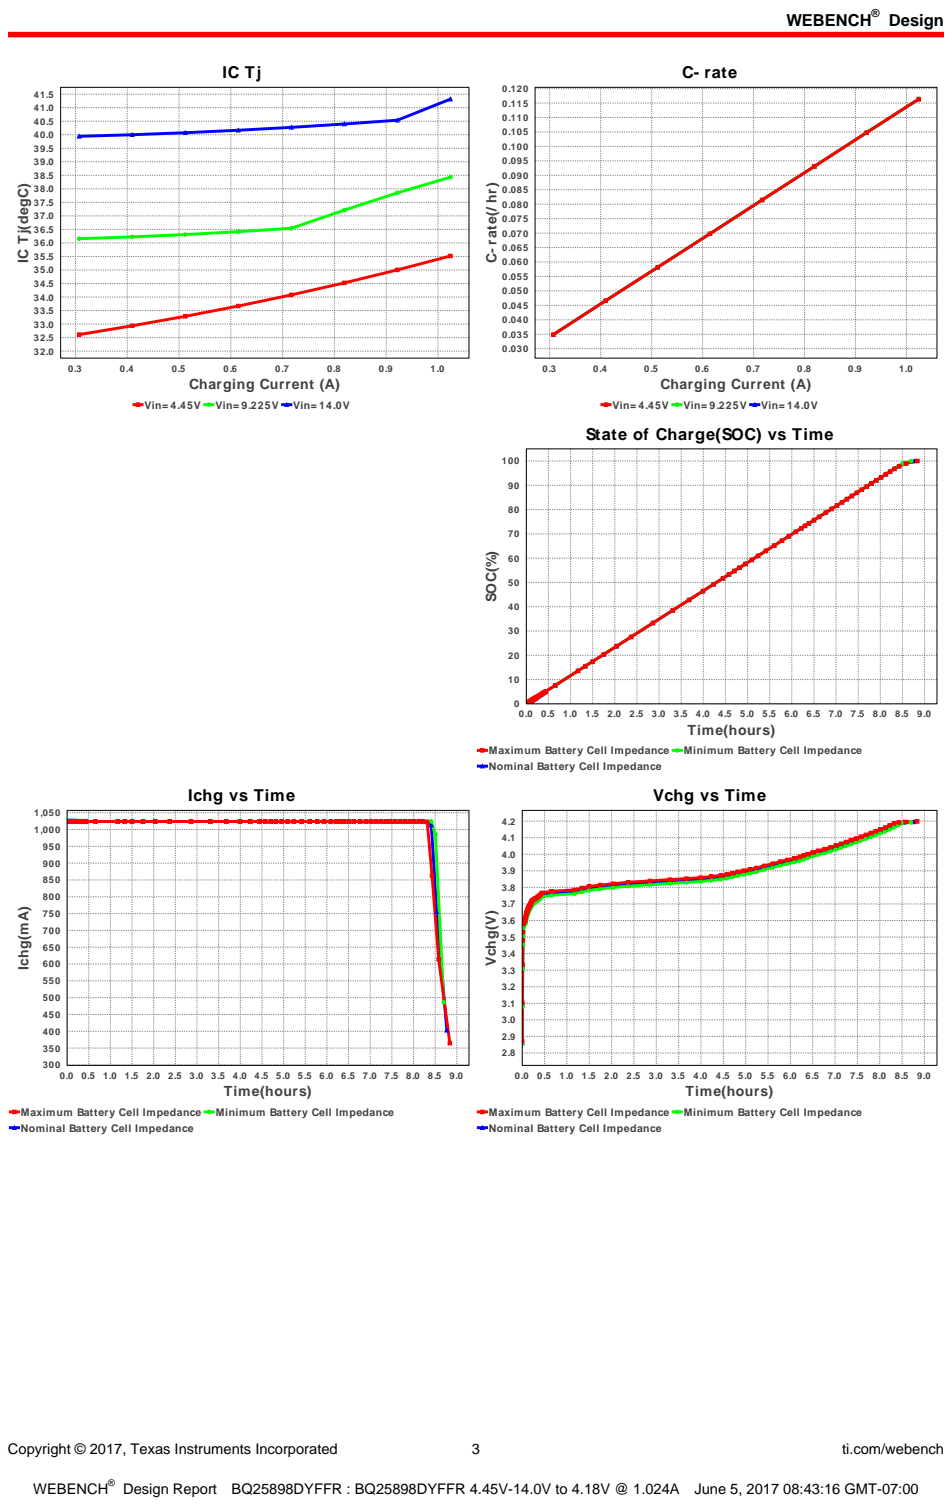
[picture p5: page 3]
Copyright © 2017, Texas Instruments Incorporated; ti.com/webench; 1.0 Charging Current (A); C- rate; C- rate(/ hr); 0.0 0.5 1.0 1.5 2.0 2.5 3.0 3.5 4.0 4.5 5.0 5.5 6.0 6.5 7.0 7.5 8.0 8.5 9.0 Time(hours); SOC(%); Ichg(mA); Vchg(V)

IC Tj(degC)

Vin= 4.45V Vin= 9.225V Vin= 14.0V

State of Charge(SOC) vs Time

Maximum Battery Cell Impedance Minimum Battery Cell Impedance
Nominal Battery Cell Impedance

Ichg vs Time

Vchg vs Time

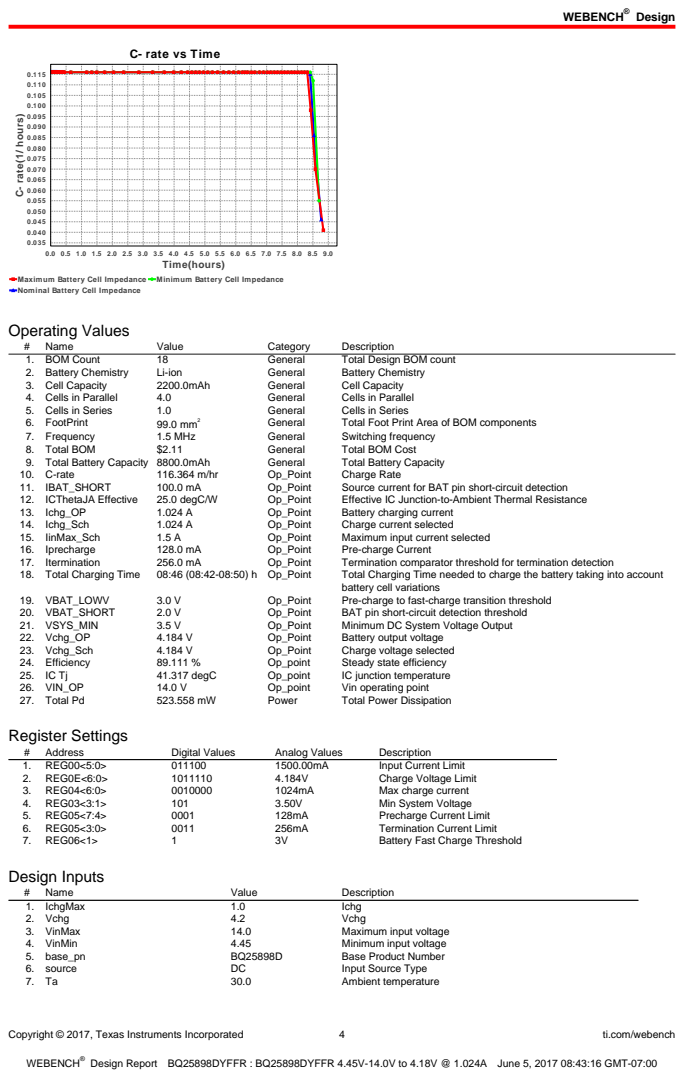
[picture p6: page 4]
Copyright © 2017, Texas Instruments Incorporated; ti.com/webench; 0.0 0.5 1.0 1.5 2.0 2.5 3.0 3.5 4.0 4.5 5.0 5.5 6.0 6.5 7.0 7.5 8.0 8.5 9.0 Time(hours); C- rate(1/ hours); Operating Values; Name; Value; Category; Description; 1. BOM Count; General; Total Design BOM count; 2. Battery Chemistry; Li-ion; Battery Chemistry; 3. Cell Capacity; 2200.0mAh; Cell Capacity; 4. Cells in Parallel; Cells in Parallel; 5. Cells in Series; Cells in Series; 6. FootPrint; 99.0 mm²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

C- rate vs Time

Maximum Battery Cell Impedance Minimum Battery Cell Impedance
Nominal Battery Cell Impedance

battery cell variations

Copyright © 2017, Texas Instruments Incorporated | 5 | ti.com/webench

## Design Assistance

1. Charge time values are estimates. Please perform board measurements to obtain a more accurate value.
2. BQ25898D Product Folder : http://www.ti.com/product/bq25898d : contains the data sheet and other resources.

Texas Instruments' WEBENCH simulation tools attempt to recreate the performance of a substantially equivalent physical implementation
of the design. Simulations are created using Texas Instruments' published specifications as well as the published specifications of other device manufacturers. While Texas Instruments does update this information periodically, this information may not be current at the time the simulation is built. Texas Instruments does not warrant the accuracy or completeness of the specifications or any information contained therein. Texas Instruments does not warrant that any designs or recommended parts will meet the specifications you entered, will be suitable for your application or fit for any particular purpose, or will operate as shown in the simulation in a physical implementation. Texas Instruments does not warrant that the designs are production worthy.
You should completely validate and test your design implementation to confirm the system functionality for your application prior to production.
Use of Texas Instruments' WEBENCH simulation tools is subject to Texas Instruments' Site Terms and Conditions of Use. (http://www.ti.com/corp/docs/legal/termsofuse.shtml) Prototype boards based on WEBENCH created designs are provided AS IS without warranty of any kind for evaluation and testing purposes and are subject to the terms of the Evaluation License Agreement. (http://www.ti.com/corp/docs/legal/termsofuse_estore.shtml)
