Wazneh/rfcx-guardian-pcb/pcb/Main_Board_2X-SOLAR_5V-DCDC.brd

## EAGLE design pcb/Main_Board_2X-SOLAR_5V-DCDC.brd (2017-09-27)

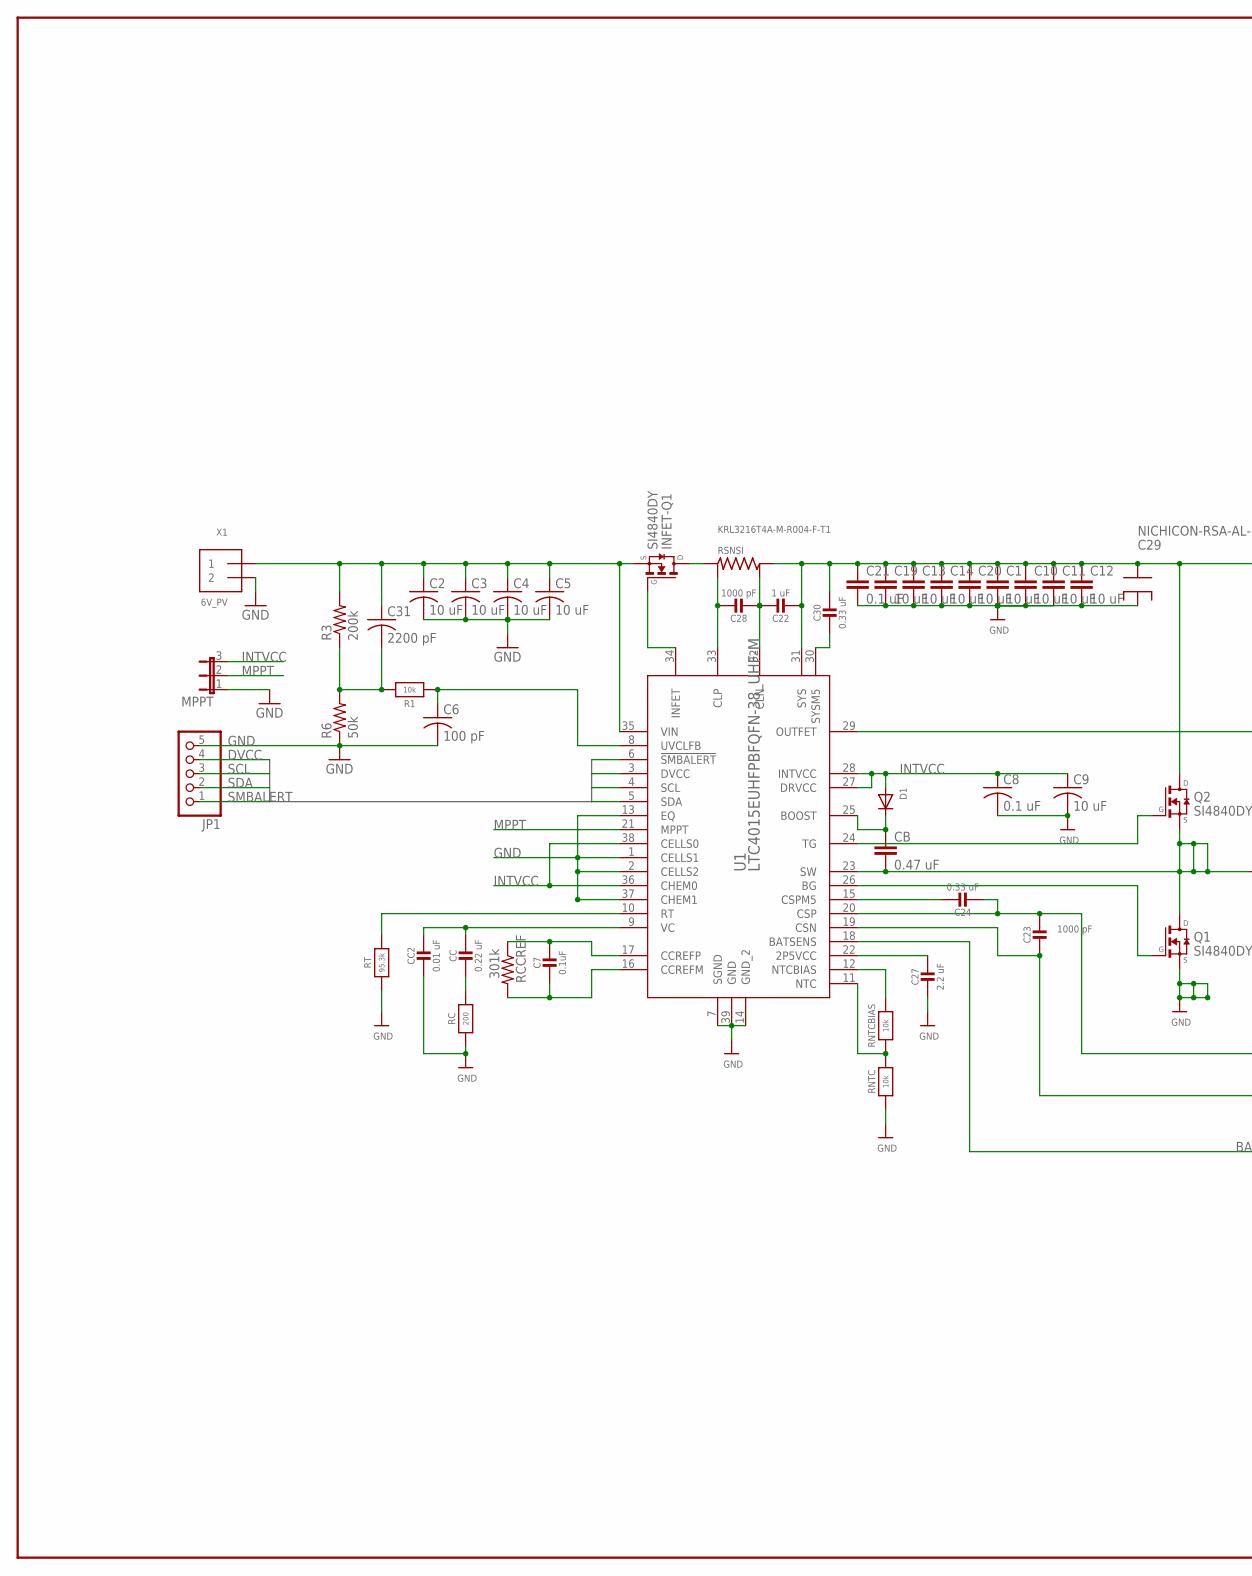
[picture p7: schematic Main_Board_2X-SOLAR_5V-DCDC.sch, part in row 1, column 1]

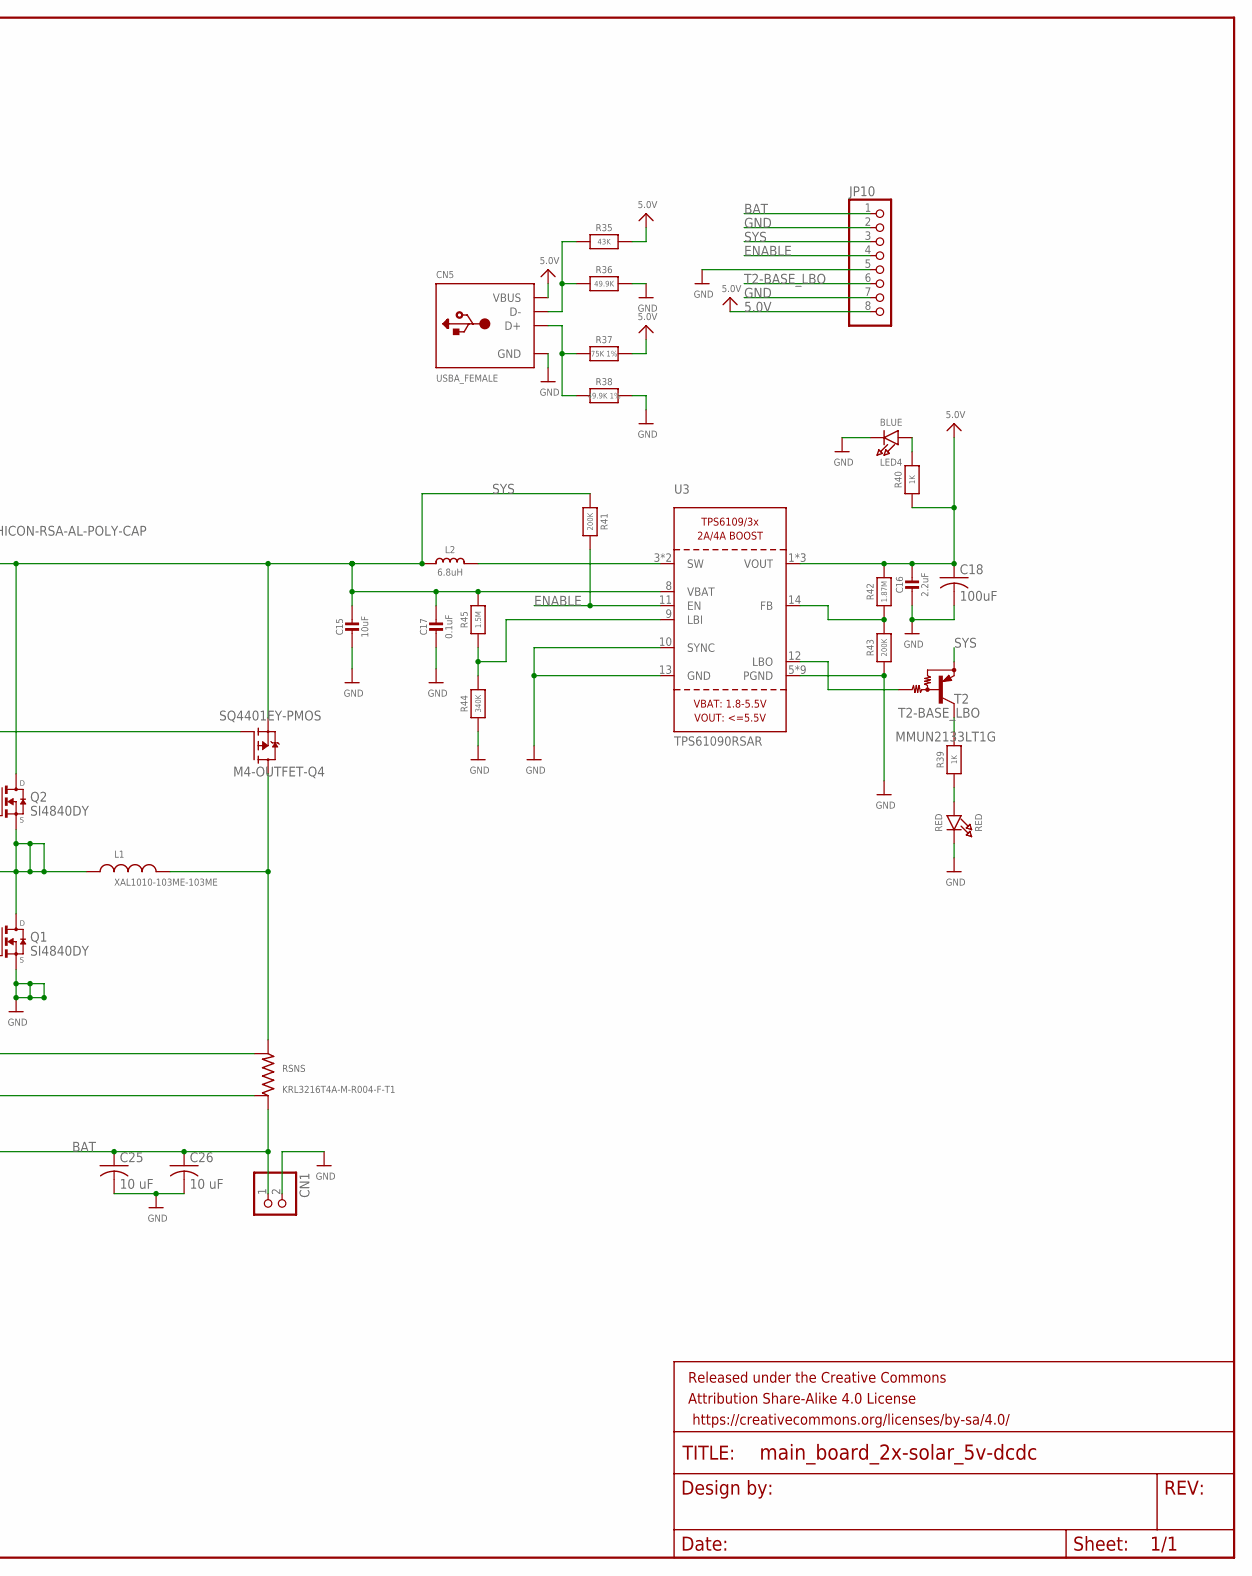
[picture p8: schematic Main_Board_2X-SOLAR_5V-DCDC.sch, part in row 1, column 2]

Parts:
C1, C10, C11, C12, C13, C14, C19, C20, C25, C26: 10 uF; C1206
C2, C3, C4, C5, C9: 10 uF; C0805
C6: 100 pF; C0805
C7, C17: 0.1uF; 0805_10MGAP
C8: 0.1 uF; C0805
C15: 10uF; 0805-NO
C16: 2.2uF; 0805-NO
C18: 100uF; C1210
C21: 0.1 uF; C1206
C22: 1 uF; 0805-NO
C23, C28: 1000 pF; 0805-NO
C24, C30: 0.33 uF; 0805-NO
C27: 2.2 uF; 0805-NO
C29: NICHICON-RSA-AL-POLY-CAP; RSA-CAP-SMD
C31: 2200 pF; C0805
CB: 0.47 uF; C1206
CC: 0.22 uF; 0805-NO
CC2: 0.01 uF; 0805-NO
CN1: JST_2PIN-THM; JST-PH-2-THM
CN5: USBA_FEMALE; USB_HOST-PTH
D1: DIODESOD-123; SOD-123
FRAME1: FRAME-LEDGER; CREATIVE_COMMONS
INFET-Q1: SI4840DY; SO08-E3
JP1: PINHD-1X5; 1X05
JP10: HEADER-1X8ROUND; 1X08_ROUND
L1: XAL1010-103ME-103ME; XAL1010
L2: 6.8uH; INDUCTOR_5X5MM_TDK_VLC5045
LED4: BLUE; CHIPLED_0805_NOOUTLINE
M4-OUTFET-Q4: SQ4401EY-PMOS; SO08-E3
MPPT: JP2E; JP2
Q1, Q2: SI4840DY; SO08-E3
R1: 10k; _0805MP
R3: 200k; R0805
R6: 50k; R0805
R35: 43K; 0805-NO
R36: 49.9K; 0805-NO
R37: 75K 1%; 0805-NO
R38: 49.9K 1%; 0805-NO
R39, R40: 1K; 0805-NO
R41, R43: 200K; 0805-NO
R42: 1.87M; 0805-NO
R44: 340K; _0805MP
R45: 1.5M; _0805MP
RC: 200; 0805-NO
RCCREF: 301k; R0805
RED: RED; CHIPLED_0805_NOOUTLINE
RNTC: 10k; _0805MP
RNTCBIAS: 10k; _0805MP
RSNS: KRL3216T4A-M-R004-F-T1; 4-TERM-RESISTOR-SUMUSU
RSNSI: KRL3216T4A-M-R004-F-T1; 4-TERM-RESISTOR-SUMUSU
RT: 95.3k; 0805-NO
T2: MMUN2133LT1G; SC59-BEC
U1: LTC4015EUHFPBFQFN-38_UHF-M; QFN-38_UHF-M
U3: TPS61090RSAR; PVQFN-16
X1: 6V_PV; TERMBLOCK_1X2-3.5MM

Connections:
2P5VCC: C27.1, U1.22 (2P5VCC)
5.0V: C16.1, C18.1, CN5.VBUS, JP10.8, R35.2, R37.2, R40.1, R42.2, U3.1 (VOUT), U3.15 (VOUT), U3.16 (VOUT)
BAT: C25.1, C26.1, CN1.1 (2), JP10.1, RSNS.P$2 (2), U1.18 (BATSENS)
BG: Q1.4 (G), U1.26 (BG)
BOOST: CB.1, D1.C, U1.25 (BOOST)
CCREFM: C7.2, RCCREF.2, U1.16 (CCREFM)
CCREFP: C7.1, RCCREF.1, U1.17 (CCREFP)
CLN: C22.1, C28.2, RSNSI.P$4 (4), U1.32 (CLN)
CLP: C28.1, RSNSI.P$3 (3), U1.33 (CLP)
CSN: C23.2, RSNS.P$4 (4), U1.19 (CSN)
CSP: C23.1, C24.2, RSNS.P$3 (3), U1.20 (CSP)
CSPM5: C24.1, U1.15 (CSPM5)
D+1: CN5.D+, R37.1, R38.1
D-1: CN5.D-, R35.1, R36.1
DVCC: JP1.4, U1.3 (DVCC)
ENABLE: JP10.4, R41.2, U3.11 (EN)
FB: R42.1, R43.2, U3.14 (FB)
GND: C1.2, C2.2, C3.2, C4.2, C5.2, C6.2, C8.2, C9.2, C10.2, C11.2, C12.2, C13.2, C14.2, C15.2, C16.2, C17.2, C18.2, C19.2, C20.2, C21.2, C25.2, C26.2, C27.2, C29.P$1, CC2.2, CN1.2 (1), CN5.GND, JP1.5, JP10.2, JP10.5, JP10.7, LED4.C, MPPT.1, Q1.1-3 (S), R6.1, R36.2, R38.2, R43.1, R44.1, RC.1, RED.C, RNTC.1, RT.1, U1.1 (CELLS1), U1.2 (CELLS2), U1.7 (SGND), U1.13 (EQ), U1.14 (GND_2), U1.37 (CHEM1), U1.39 (GND), U3.5 (PGND), U3.6 (PGND), U3.7 (PGND), U3.10 (SYNC), U3.13 (GND), U3.P$18 (PGND), U3.P$19 (PGND), U3.P$20 (PGND), U3.P$21 (PGND), U3.P$22 (PGND), U3.THERMAL (PGND), X1.2
INFET: INFET-Q1.4 (G), U1.34 (INFET)
INTVCC: C8.1, C9.1, D1.A, MPPT.3, U1.27 (DRVCC), U1.28 (INTVCC), U1.36 (CHEM0), U1.38 (CELLS0)
LBI: R44.2, R45.1, U3.9 (LBI)
LED+: LED4.A, R40.2
MPPT: MPPT.2, U1.21 (MPPT)
unnamed: R39.1, RED.A
unnamed: INFET-Q1.5-8 (D), RSNSI.P$1 (1)
unnamed: C6.1, R1.1, U1.8 (UVCLFB)
unnamed: CC.2, RC.2
unnamed: RNTC.2, RNTCBIAS.1, U1.11 (NTC)
NTCBIAS: RNTCBIAS.2, U1.12 (NTCBIAS)
OUTFET: M4-OUTFET-Q4.4 (G), U1.29 (OUTFET)
OUTFET_M4_BAT: L1.P$2, M4-OUTFET-Q4.5-8 (D), RSNS.P$1 (1)
RT: RT.2, U1.10 (RT)
SCL: JP1.3, U1.4 (SCL)
SDA: JP1.2, U1.5 (SDA)
SMBALERT: JP1.1, U1.6 (!SMBALERT)
SW: L2.P$2 (2), U3.3 (SW), U3.4 (SW)
SW_LTC: CB.2, L1.P$1, Q1.5-8 (D), Q2.1-3 (S), U1.23 (SW)
SYS: C1.1, C10.1, C11.1, C12.1, C13.1, C14.1, C15.1, C17.1, C19.1, C20.1, C21.1, C22.2, C29.P$2, C30.1, JP10.3, L2.P$1 (1), M4-OUTFET-Q4.1-3 (S), Q2.5-8 (D), R41.1, R45.2, RSNSI.P$2 (2), T2.E, U1.31 (SYS), U3.8 (VBAT)
SYSM5: C30.2, U1.30 (SYSM5)
T2-BASE_LBO: JP10.6, T2.B, U3.12 (LBO)
T2-DRAIN: R39.2, T2.C
TG: Q2.4 (G), U1.24 (TG)
UVCLFB: C31.2, R1.2, R3.1, R6.2
VC: CC.1, CC2.1, U1.9 (VC)
VIN: C2.1, C3.1, C4.1, C5.1, C31.1, INFET-Q1.1-3 (S), R3.2, U1.35 (VIN), X1.1

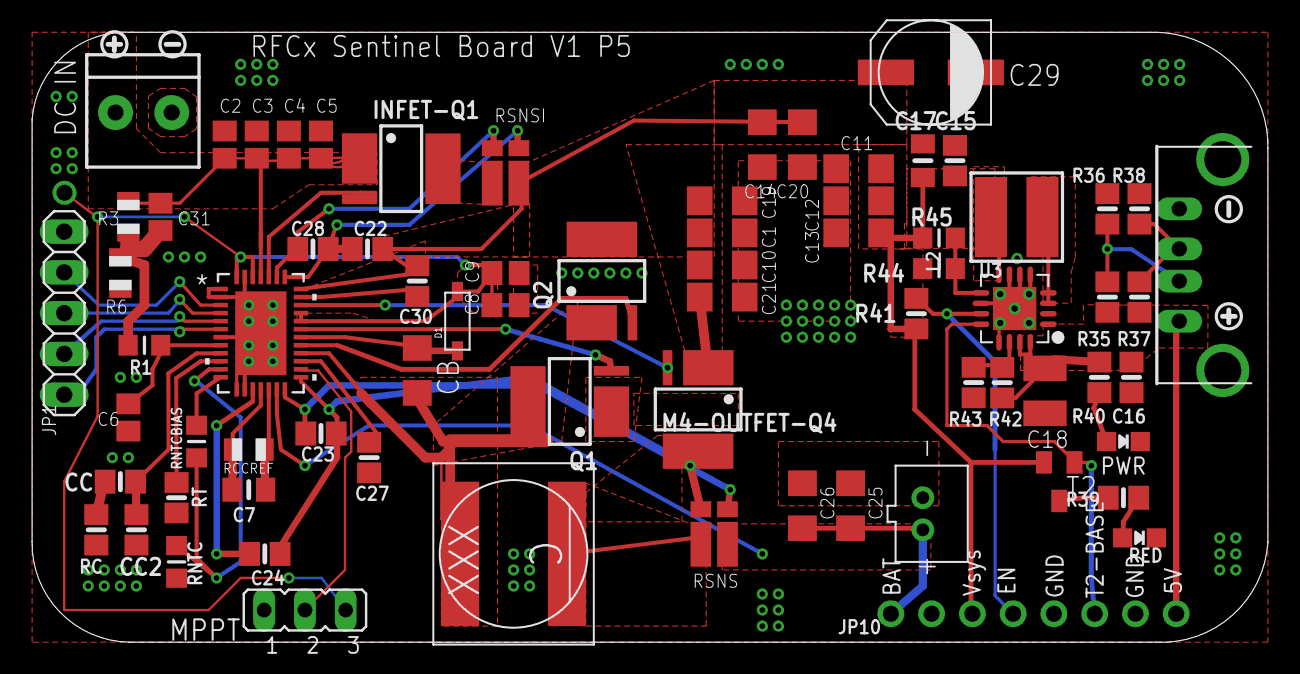
[picture p9: board Main_Board_2X-SOLAR_5V-DCDC.brd from above]

Board: 2 copper layers, 77.0 x 38.0 mm, 78 parts (0 on the bottom side), 45 nets.

Other parts of the board:
U$2, U$86: SYMBOL_PLUS
U$13, U$87: SYMBOL_MINUS
