Wazneh/rfcx-guardian-pcb/(commit log)

2017-05-31 Basic initial main board
    PCB and schematic layout of 2 solar battery chargers mostly completed. Copied 5V D/DC step-up into project. Need to add jumpers and complete routing for diodes and capacitors on solar battery chargers.
    [Main_Board_2X-SOLAR_5V-DCDC.brd, Main_Board_2X-SOLAR_5V-DCDC.sch]
2017-06-01 Added 5V board and fixed PCB layout
    Added 5V step up board loayout to main PCB. Removed additional MCP module from 5V layout.
    [Main_Board_2X-SOLAR_5V-DCDC.brd, Main_Board_2X-SOLAR_5V-DCDC.sch]
2017-06-02 PCB manufacturing and assembly quotes
    Adding quotes from different PCB services
    [PCB_mfg_quotes.xlsx]
2017-06-05 Completed board layout
    Completed layout for 2 MCP chips and TI 5V step-up boost. MCP load outputs merged and routed to 5V step-up, no 5V power wires needed. Added terminal block option for solar panel input. Added BOM folder and PCB quotes spreadsheet.
    [DRILEGEND.CFG, Main_Board_2X-SOLAR_5V-DCDC.brd, Main_Board_2X-SOLAR_5V-DCDC.sch, PCB_mfg_quotes.xlsx, a-sample-of-PCBWay-BOM.xlsx]
2017-06-06 PCB board rev 1
    Files used to print prototype from bayareacircuits. Adding BOM file and CAM/GERBER files
    [BOM_Main_Board_2X-SOLAR_5V-DCDC_digikey.xlsx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]
2017-06-07 Rev 2 start
    Removed extra USB mounts, jumpers, and headers. BOM completed but missing a couple items from Digikey
    [BOM_Main_Board_2X-SOLAR_5V-DCDC_digikey.xlsx, Main_Board_2X-SOLAR_5V-DCDC.brd, Main_Board_2X-SOLAR_5V-DCDC.sch]
2017-06-07 Final BOM
    Updated BOM to final
    [BOM_Main_Board_2X-SOLAR_5V-DCDC_digikey.xlsx]
2017-06-08 updated bom
    [BOM_Main_Board_2X-SOLAR_5V-DCDC_digikey.xlsx]
2017-06-08 updated original rev 0 board
    commiting to master to save all files from first print
    [DRILEGEND.CFG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]
2017-06-08 reorganization of files for rev 2
    moved gerber files to seperate folder
    [DRILEGEND.CFG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]
2017-06-08 Part removal and gitignore update
    removed more jumpers and headers and updated the ignore file to ignore autosave files
    [Main_Board_2X-SOLAR_5V-DCDC.brd, Main_Board_2X-SOLAR_5V-DCDC.sch]
2017-06-11 Added jumpers and diodes to load line regulation
    [Main_Board_2X-SOLAR_5V-DCDC.brd, Main_Board_2X-SOLAR_5V-DCDC.sch]
2017-06-11 Removal of extra files
    Moved Gerber files to serperate folder
    [DRILEGEND.CFG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]
2017-06-13 Cleaned up silkscreen
    Moved silkscreen for better visibility during assembly and deleted extra labels. Shrank board a little bit smaller in dimension
    [Main_Board_2X-SOLAR_5V-DCDC.brd, Main_Board_2X-SOLAR_5V-DCDC.sch]
2017-06-15 updated layout and BOM
    [BOM_Main_Board_2X-SOLAR_5V-DCDC_digikey.xlsx, Main_Board_2X-SOLAR_5V-DCDC.brd]
2017-06-20 BOM update
    [BOM_Main_Board_2X-SOLAR_5V-DCDC_digikey.xlsx]
2017-07-02 OSH revision. No jumpers, compressed layout
    Shrank the layout of the board to a smaller size and removed the jumpers for easier assembly
    [Main_Board_2X-SOLAR_5V-DCDC.brd, Main_Board_2X-SOLAR_5V-DCDC.sch]
2017-07-13 updated BOM
    Updated BOM to match new layout. Removed a few resistors and consolidated duplicate line items
    [BOM_Main_Board_2X-SOLAR_5V-DCDC_digikey.xlsx, PCB_mfg_quotes.xlsx]
2017-07-19 Updated BOM for master repo
    BOM updated to match board layout and added prices
    [BOM_Main_Board_2X-SOLAR_5V-DCDC_digikey.xlsx]
2017-07-19 BOM additions and adjustments
    Added vertical USB-A female receptacle
    [BOM_Main_Board_2X-SOLAR_5V-DCDC_digikey.xlsx]
2017-07-25 Bom update
    Minor formatting update
    [BOM_Main_Board_2X-SOLAR_5V-DCDC_digikey.xlsx]
2017-08-07 updaled to new BOM for assembly and regenerated gerber files
    [BOM_RFCX_POWER_BOARD_R1.xlsx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]
2017-08-11 updated GERBER zip with outline file
    Added GKO outline file to GERBER
    [Main_Board_2X-SOLAR_5V-DCDC.GKO]
2017-08-14 Updated BOM for R1
    Updated diode part list to match quantity
    [BOM_RFCX_POWER_BOARD_R1.xlsx]
2017-08-14 Updated schematic text
    Updated labels in schematic to reduce clutter
    [Main_Board_2X-SOLAR_5V-DCDC.sch]
2017-09-23 Updated layout
    [Main_Board_2X-SOLAR_5V-DCDC.brd, Main_Board_2X-SOLAR_5V-DCDC.sch]
2017-09-23 Updated Sentinel Board with larger FETs
    [Main_Board_2X-SOLAR_5V-DCDC.brd, Main_Board_2X-SOLAR_5V-DCDC.sch]
2017-09-27 Updated layout sizing, ground plane thermals, and silkscreen positions
    Shrank board size slightly and aligned edges. Made component silk screens easier to read and adjusted ground planes on Csys and INT/DRVcc GND
    [Main_Board_2X-SOLAR_5V-DCDC.brd, Main_Board_2X-SOLAR_5V-DCDC.sch]
